BaDaQu/WATIR_IoT/DOKUMENTY/Schemat.pdf

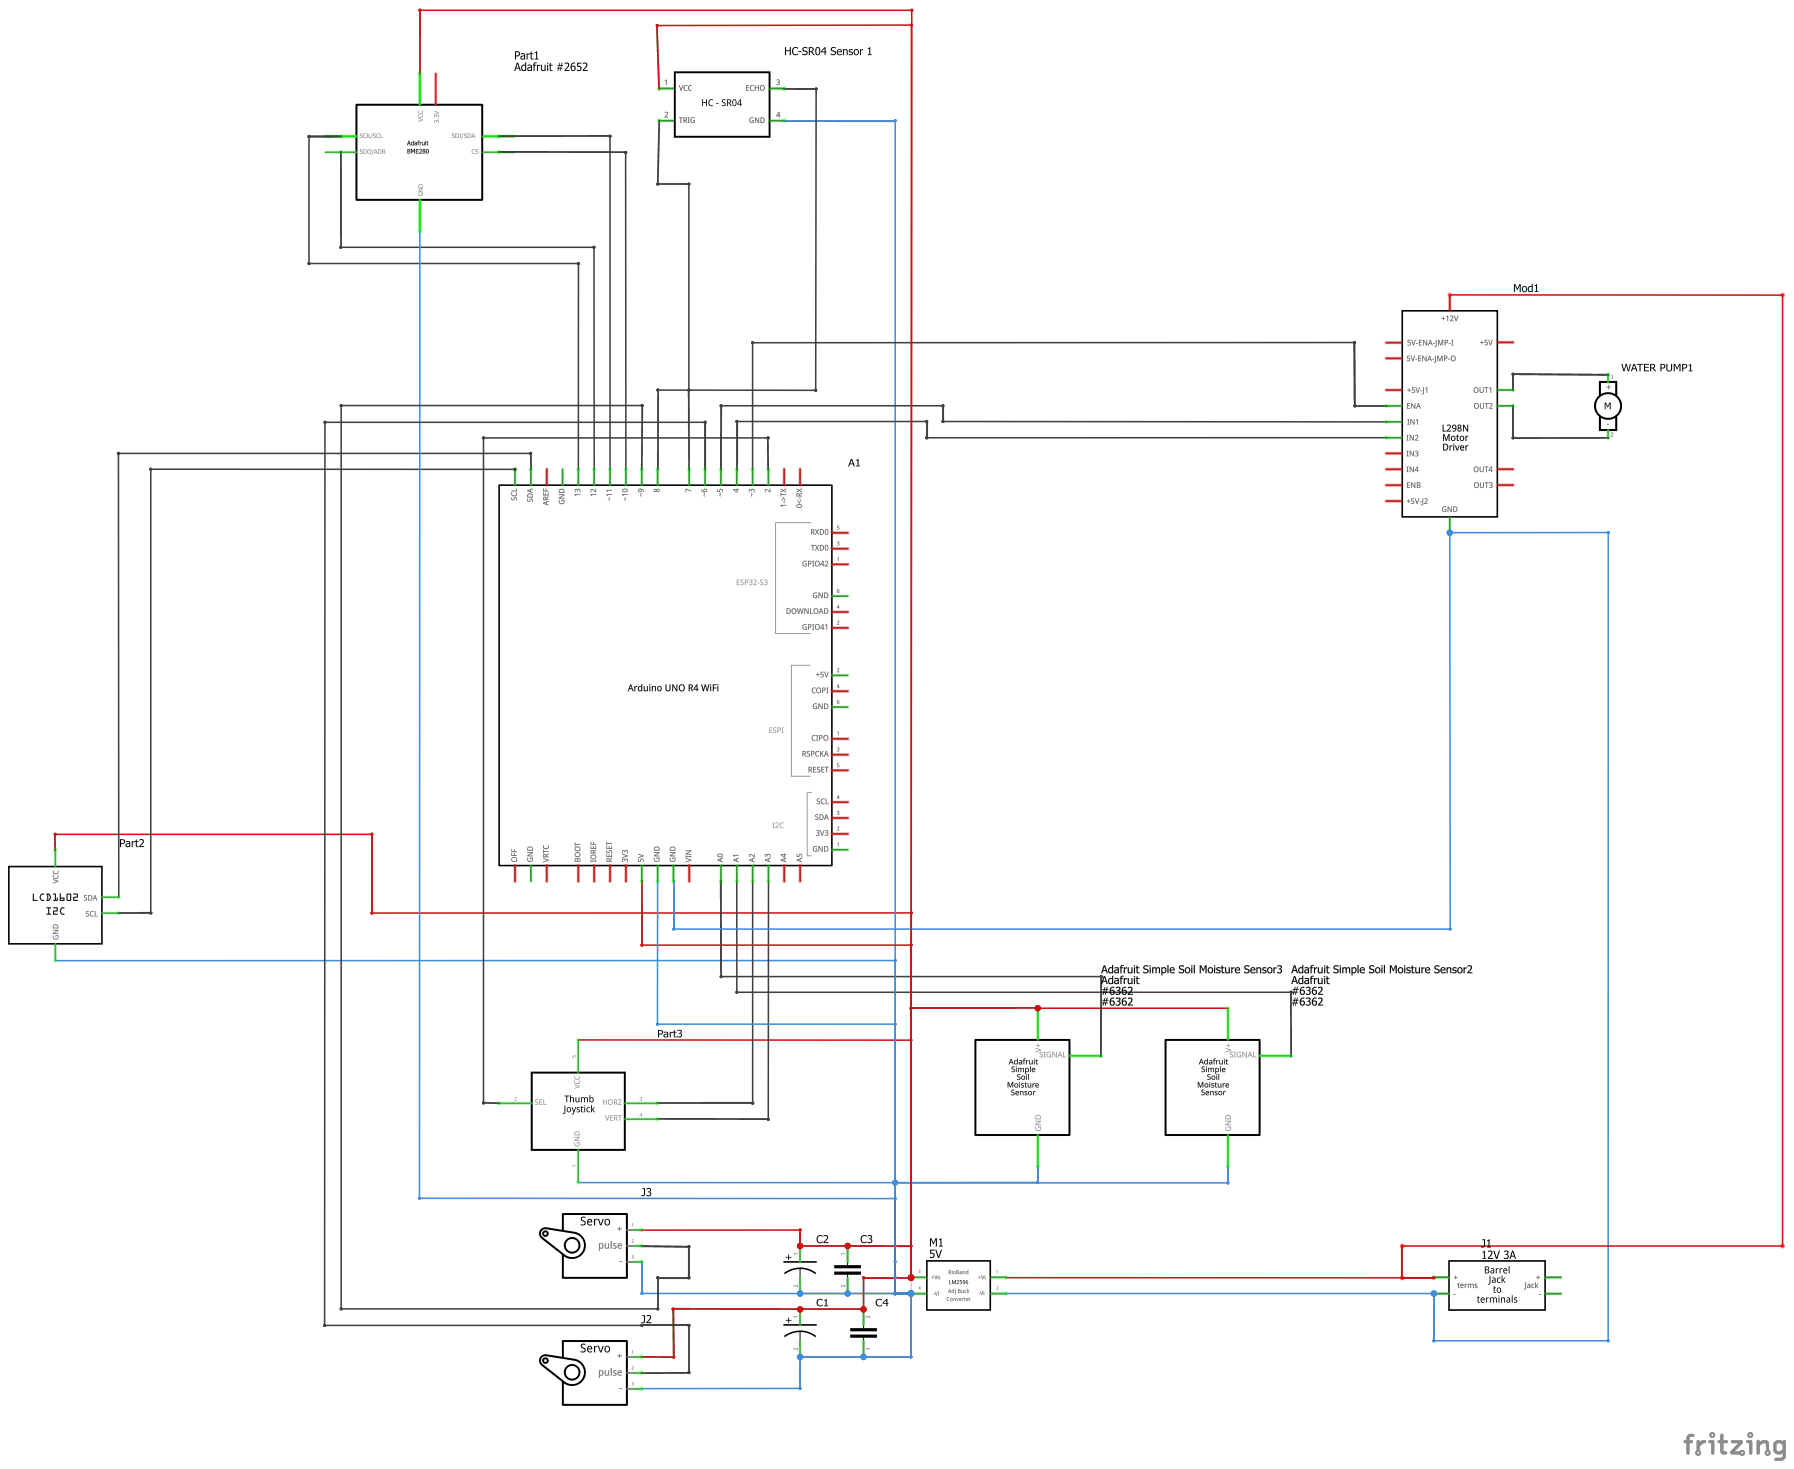
[picture p19: page 1]
