BaDaQu/WATIR_IoT/firmware/WATIR-ARDUINO/DisplayMenu.h

// ============================================
// WATIR IoT — Firmware dla Arduino UNO R4 WiFi
// ============================================
//
// Moduł: Wyświetlacz
// Plik nagłówkowy dla funkcji obsługujących ekran LCD I2C.
//

#ifndef DISPLAY_MENU_H
#define DISPLAY_MENU_H
#include <Arduino.h>

void konfigurujWyswietlacz();
void runLcdConfigMenu();

#endif
