BaDaQu/WATIR_IoT/(commit log)

2026-05-07 feat: implementacja wirtualnego joysticka 2D i panelu akcji closes #26
2026-05-07 Dodanie firmware Arduino. Closes #16, closes #17, closes #18
2026-06-14 feat(viewmodel): implement throttled sendMove logic for pan and tilt
2026-07-08 feat: migracja firmware z Arduino UNO R3 + ESP8266 na Arduino UNO R4 WiFi
    BREAKING CHANGE: Całkowita zmiana platformy sprzętowej
    Firmware:
    - Migracja z Arduino UNO R3 + ESP8266 na Arduino UNO R4 WiFi
    - WiFi wbudowane w R4 — usunięta komunikacja UART z ESP
    - BME280 przeniesiony z I2C na SPI (pins 10-13) — I2C na R4 WiFi
    nie wykrywał czujnika
    - Pompa: wymiana przekaźnika na sterownik L298N (12V/2A)
    - ENA → Pin 3 (PWM regulacja mocy 0-100%)
    - IN1 → Pin 5, IN2 → Pin 4
    - Nowy endpoint POST /api/pump (power, duration, status)
    - Konfigurowalna moc pompy (domyślnie 70%)
    - Nowy endpoint POST /api/config z parametrem pump_power
    - Telemetria raportuje pump_power w obiekcie st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
2026-07-09 feat(firmware): Migrate to Arduino UNO R4 WiFi & L298N
2026-07-09 feat: add functionality to change pump power and to water a plant
2026-07-11 feat: Kompleksowe zmiany - Slider pompy, UDP, LCD i dokumentacja
    Dzisiejsze zmiany:
    - Dodanie slidera mocy pompy (0-100%) w aplikacji Android (JoystickScreen)
    - Wybór przypisania czujników gleby (G1/G2) do profili roślin w ustawieniach
    - Implementacja Auto-Discovery na podstawie UDP Broadcast na porcie 3000
    - Wieloaspektowe poprawki UDP: czyszczenie całego bufora odbieranego
    - Optymalizacja odświeżania I2C dla LCD (redukcja zawieszania mikrokontrolera)
    - Lepsza logika joysticka zapobiegająca blokowaniu ruchów w osi X i Y
    - Aktualizacja i ujednolicenie dokumentacji na górze wszystkich plików C++
2026-07-13 Final adjustments to servo limits, axis mapping, and app logic
2026-07-15 Fix initialization of BME280 sensor
    [Sensors.cpp]
2026-07-15 Update Watering.cpp
    Removed warning about A4/A5 pins being used for I2C.
